JPLabsystems/JPL.mp3/README.md

# JPL.mp3
*The iPod endgame does not exist.*  
An iPod-esque mp3 player based on the ESP32 platform.

See YouTube video and Blog post for more details!
