JPLabsystems/JPL.mp3/production/README.md

## Note

It is highly recomended that you review all source files carefully before manufacturing this device. Source code particularly has many unresolved bugs which may impact user experience
