JPLabsystems/JPL.mp3/cad/NEWBackplate.3mf

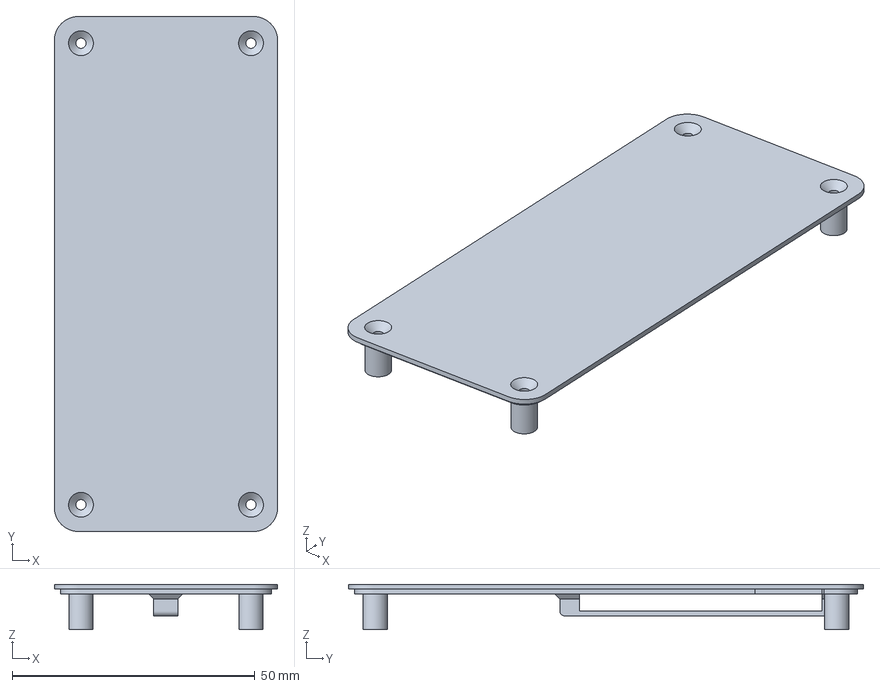
[picture p1: CAD file, 2025-09-06]
cad/NEWBackplate.3mf
46.0 x 106.0 x 9.35 mm
