JPLabsystems/JPL.mp3/production/3d_print/backplate.3mf

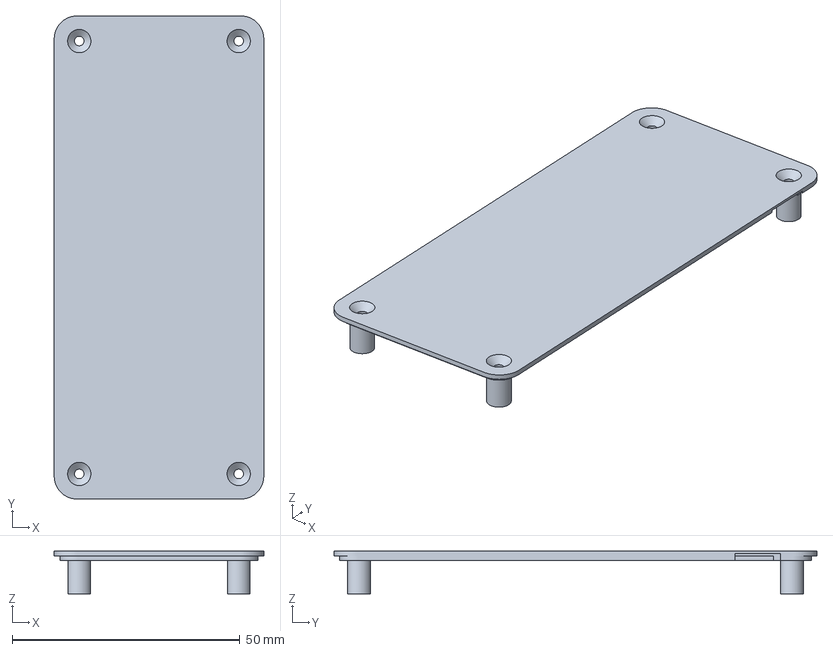
[picture p2: CAD file, 2025-08-03]
production/3d_print/backplate.3mf
46.0 x 106.0 x 9.35 mm
