JPLabsystems/JPL.mp3/cad/m1.44mmphilips.FCStd

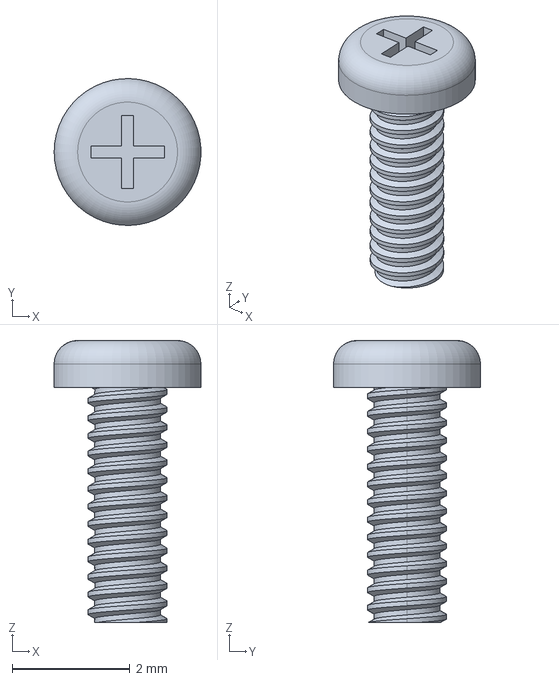
[picture p3: CAD file, 2025-07-11]
cad/m1.44mmphilips.FCStd
2.50 x 2.50 x 4.80 mm
