JPLabsystems/JPL.mp3/production/3d_print/slider.3mf

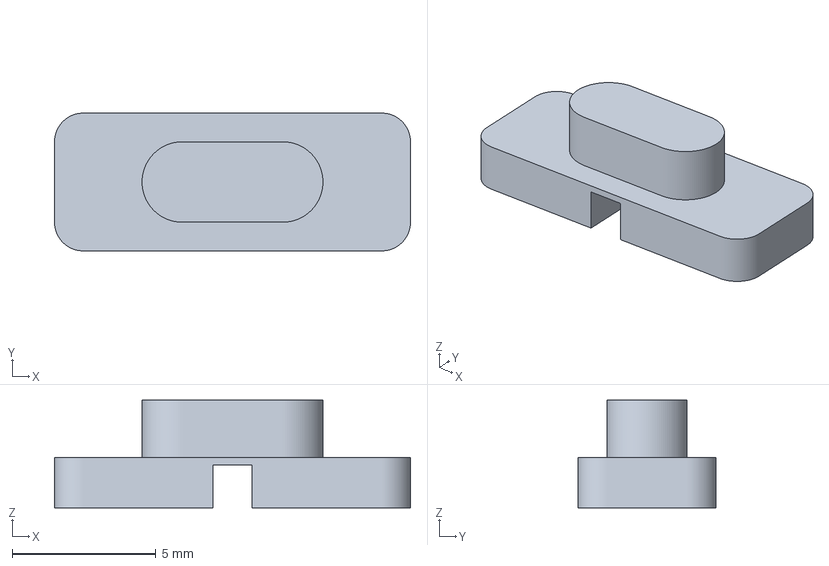
[picture p4: CAD file, 2025-08-03]
production/3d_print/slider.3mf
12.4 x 4.80 x 3.75 mm
