JPLabsystems/JPL.mp3/cad/m214mmcstorx.FCStd

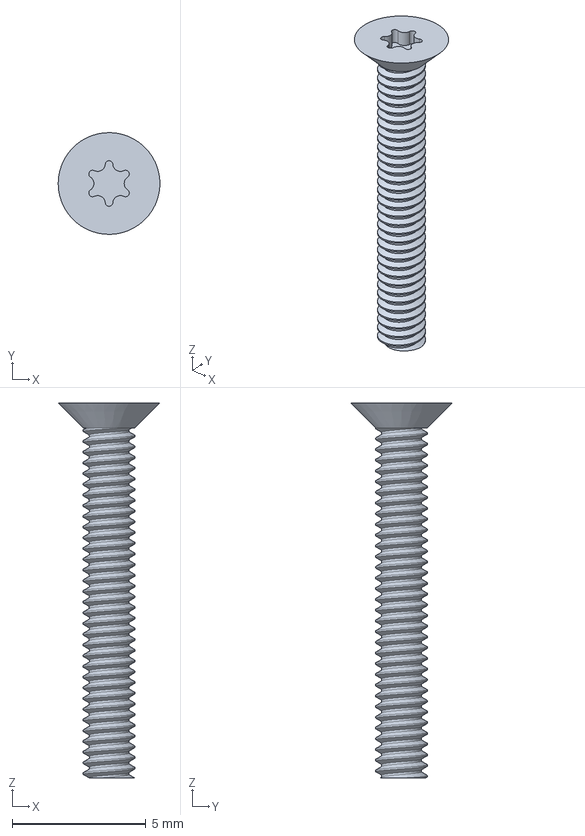
[picture p5: CAD file, 2025-07-11]
cad/m214mmcstorx.FCStd
3.80 x 3.80 x 14.0 mm
