JPLabsystems/JPL.mp3/production/3d_print/housing.3mf

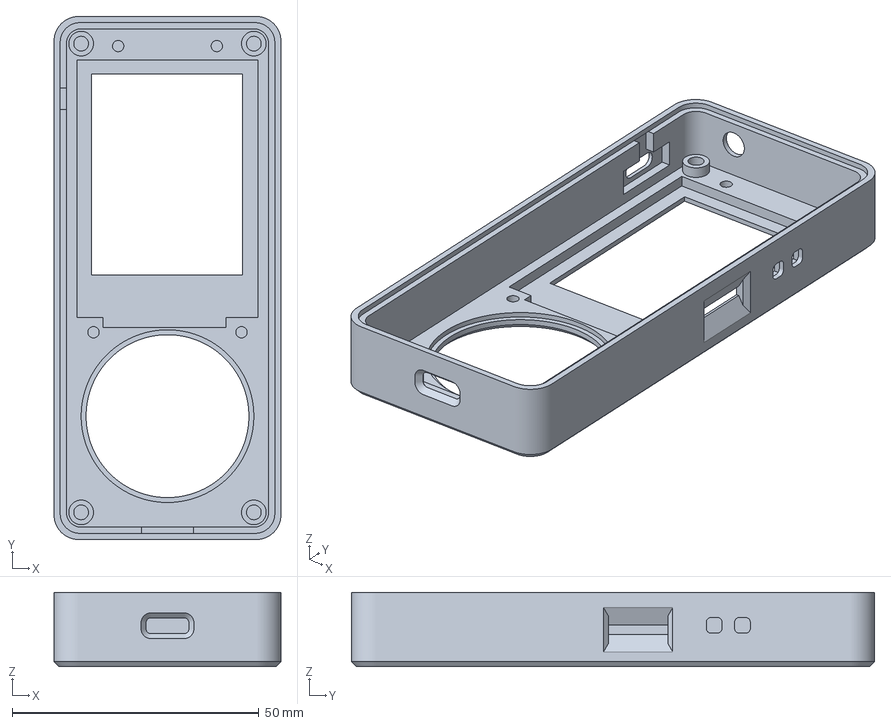
[picture p6: CAD file, 2025-08-03]
production/3d_print/housing.3mf
46.0 x 106.0 x 15.0 mm
