JPLabsystems/JPL.mp3/cad/PCB.FCStd

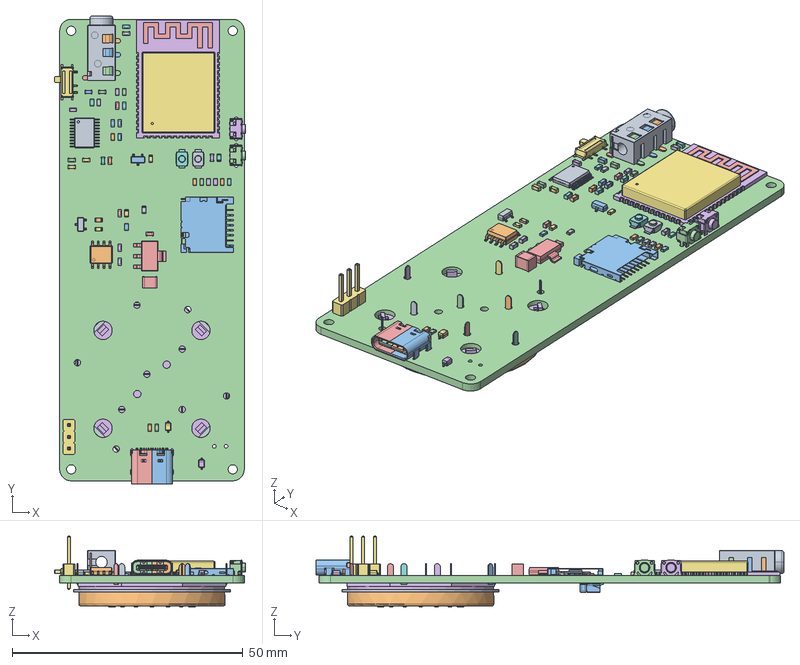
[picture p7: CAD file, 2025-07-11]
cad/PCB.FCStd
41.5 x 101.4 x 15.3 mm
PJ320D
PJ320D001
PJ320D002
PJ320D003
PJ320D004
R_0603_1608Metric
R_0603_1608Metric002
R_0603_1608Metric004
C_0603_1608Metric
C_0603_1608Metric002
SOT_23
R_0603_1608Metric006
ESP32-S3-WROOM-1
ESP32-S3-WROOM-002
ESP32-S3-WROOM-003
ESP32-S3-WROOM-004
ESP32-S3-WROOM-005
ESP32-S3-WROOM-006
ESP32-S3-WROOM-007
ESP32-S3-WROOM-008
ESP32-S3-WROOM-009
ESP32-S3-WROOM-010
ESP32-S3-WROOM-011
ESP32-S3-WROOM-012
ESP32-S3-WROOM-013
ESP32-S3-WROOM-014
ESP32-S3-WROOM-015
ESP32-S3-WROOM-016
ESP32-S3-WROOM-017
ESP32-S3-WROOM-018
ESP32-S3-WROOM-019
ESP32-S3-WROOM-020
ESP32-S3-WROOM-021
ESP32-S3-WROOM-022
ESP32-S3-WROOM-023
ESP32-S3-WROOM-024
ESP32-S3-WROOM-025
ESP32-S3-WROOM-026
ESP32-S3-WROOM-027
ESP32-S3-WROOM-028
ESP32-S3-WROOM-029
ESP32-S3-WROOM-030
ESP32-S3-WROOM-031
ESP32-S3-WROOM-032
ESP32-S3-WROOM-033
ESP32-S3-WROOM-034
ESP32-S3-WROOM-035
ESP32-S3-WROOM-036
ESP32-S3-WROOM-037
ESP32-S3-WROOM-038
ESP32-S3-WROOM-039
ESP32-S3-WROOM-040
ESP32-S3-WROOM-041
ESP32-S3-WROOM-042
ESP32-S3-WROOM-043
ESP32-S3-WROOM-044
ESP32-S3-WROOM-045
ESP32-S3-WROOM-046
ESP32-S3-WROOM-047
ESP32-S3-WROOM-048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
