JPLabsystems/JPL.mp3/production/3d_print/midplate.3mf

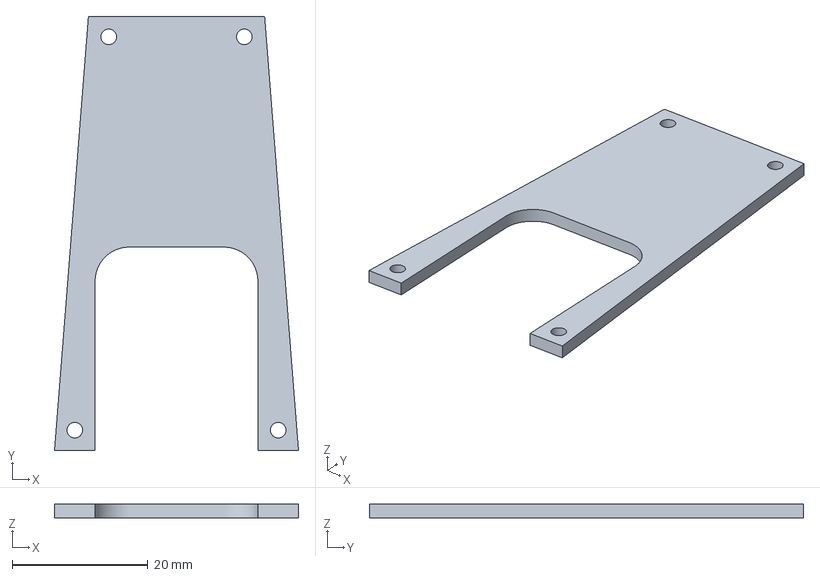
[picture p8: CAD file, 2025-08-03]
production/3d_print/midplate.3mf
36.0 x 64.0 x 2.00 mm
