JPLabsystems/JPL.mp3/cad/displayHS20HS072RX.FCStd

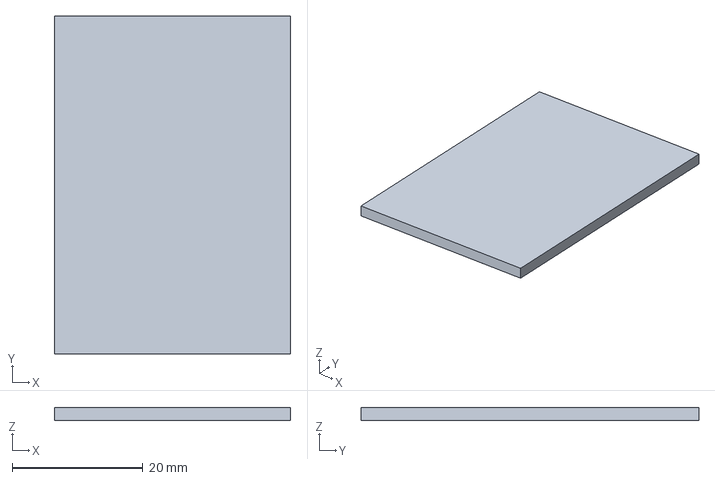
[picture p9: CAD file, 2025-07-11]
cad/displayHS20HS072RX.FCStd
36.2 x 51.8 x 2.05 mm
