JPLabsystems/JPL.mp3/production/3d_print/button.3mf

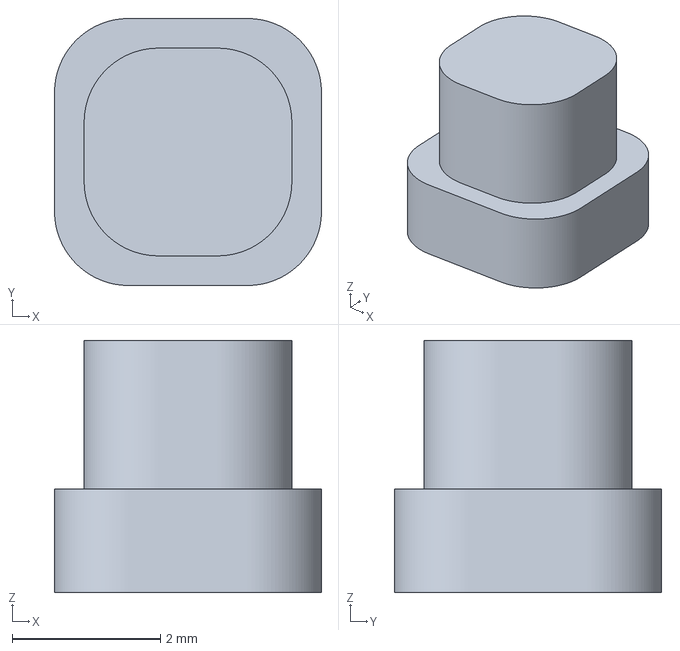
[picture p10: CAD file, 2025-08-03]
production/3d_print/button.3mf
3.60 x 3.60 x 3.40 mm
