JPLabsystems/JPL.mp3/cad/LiPo.FCStd

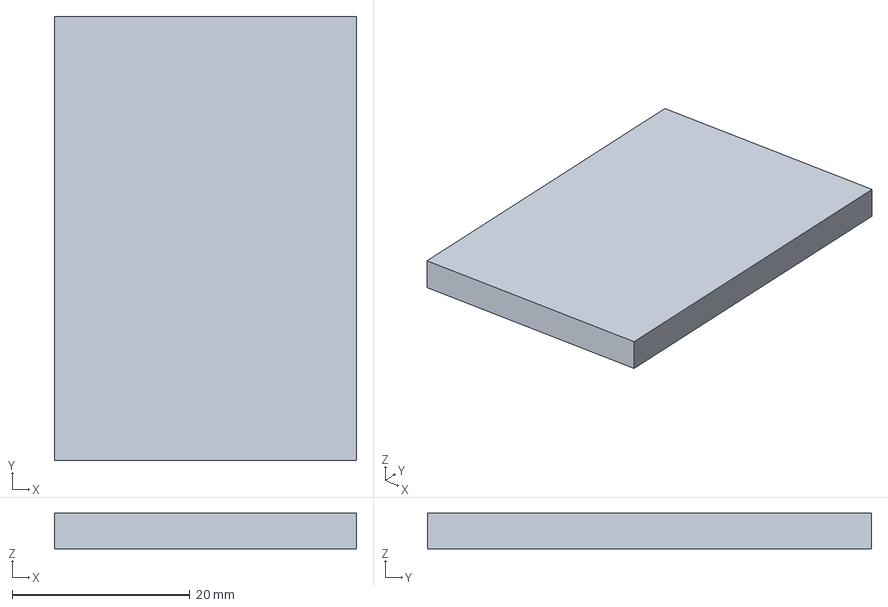
[picture p11: CAD file, 2025-07-11]
cad/LiPo.FCStd
34.0 x 50.0 x 4.00 mm
