JPLabsystems/JPL.mp3/(list of files, cad)

Other CAD files:
cad/Slider.FCStd
cad/Body.FCStd
cad/Button.FCStd
