JPLabsystems/JPL.mp3/eda/JPL.mp3.kicad_pcb

## KiCad design eda/JPL.mp3.kicad_pcb (2025-01-02)

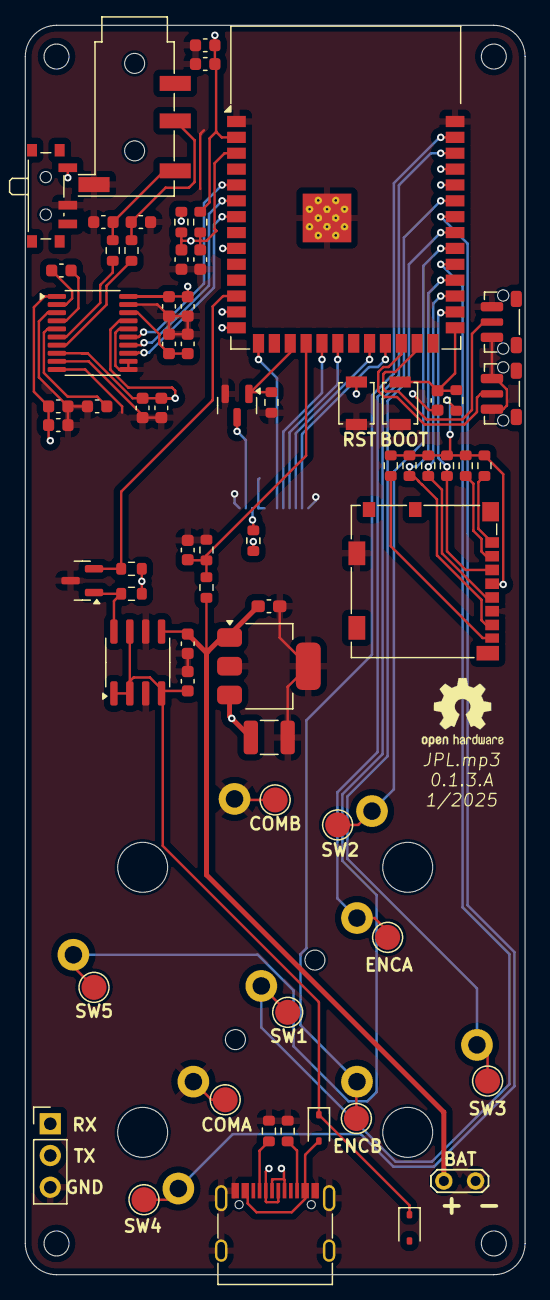
[picture p12: board JPL.mp3.kicad_pcb from above]

Board: 4 copper layers, 40.0 x 100.0 mm, 70 parts (1 on the bottom side), 51 nets.

Parts:
BAT: TestPoint_2Pads_Pitch2.54mm_Drill0.8mm
BOOT1: BOOT; SW_SPST_B3U-1000P
C1: .47uF; C_0603_1608Metric_Pad1.08x0.95mm_HandSolder
C2: 47uF; C_1210_3225Metric
C3, C4: 2.2nF; C_0603_1608Metric
C5, C9, C15, C19, C21: .1uF; C_0603_1608Metric
C6, C10, C16, C20, C23: 10uF; C_0603_1608Metric
C7: 2.2 uF; C_0603_1608Metric
C8: 10 nF; C_0603_1608Metric
C11, C13: 0.1uF; C_0603_1608Metric
C12: 1uF; C_0603_1608Metric
C14: 4.7 uF; C_0603_1608Metric
C17, C18: 2.2uF; C_0603_1608Metric
COMA: TestPoint_Pad_D2.0mm
COMB: TestPoint_Pad_D2.0mm
D1, D2: 1N5819WS; D_SOD-323
ENCA: TestPoint_Pad_D2.0mm
ENCB: TestPoint_Pad_D2.0mm
Enc1: ANO Rotary Encoder
J1: Micro_SD_Card; microSD_HC_Molex_104031-0811
J2: USB_C; USB_C_Receptacle_G-Switch_GT-USB-7010ASV
J4: Conn_01x12; TE_1-1734839-2_1x12-1MP_P0.5mm_Horizontal
J5: AudioJack3; Jack_3.5mm_KoreanHropartsElec_PJ-320D-4A_Horizontal
J6: Conn_01x03_Pin; PinHeader_1x03_P2.54mm_Vertical
Q1, Q2: BSS138; SOT-23
R1, R2: 5.1K; R_0603_1608Metric
R3, R8, R9, R10, R11, R13, R14, R15, R16, R17, R18, R19: 10K; R_0603_1608Metric
R4, R5: 470; R_0603_1608Metric
R6, R7: 100K; R_0603_1608Metric
R12: 10; R_0603_1608Metric
RST1: SW_SPST; SW_SPST_B3U-1000P
SL2: HOLD; SW_SPDT_PCM12
SW1, SW2#2, SW3, SW4, SW5: TestPoint_Pad_D2.0mm
SW1#2, SW2: SW_Push; SW_Push_1P1T-MP_NO_Horizontal_Alps_SKRTLAE010
U1: ESP32-S3-WROOM-1
U2: MAX1811; SOIC-8_3.9x4.9mm_P1.27mm
U4: PCM5102A; TSSOP-20_4.4x6.5mm_P0.65mm
U5: LT1963AxST-3.3; SOT-223-3_TabPin2

Connections:
+3.3V: C2.1, C6.1, C9.1, C10.1, C15.1, C19.2, C20.1, C21.2, C23.1, J1.4 (VDD), J4.8, J4.9, R3.1, R8.2, R9.1, R10.2, R12.1, R13.2, R14.1, R15.2, R16.2, R17.1, R18.1, R19.1, U1.2 (3V3), U4.1 (CPVDD), U4.8 (AVDD), U4.17 (XSMT), U4.20 (DVDD), U5.3 (OUT)
+5V: C14.1, D1.1 (K), D2.1 (K), U2.1 (SELV), U2.2 (SELI), U2.4 (IN), U2.7 (EN)
AUDIO_LEFT: C3.1, J5.T, R4.2
AUDIO_RIGHT: C4.1, J5.R1, R5.2
BACKLIGHT: Q2.1 (G), R11.1, U1.17 (GPIO9/TOUCH9/ADC1_CH8/FSPIHD/SUBSPIHD)
BAT_SENSE: C8.2, R6.2, R7.1, U1.18 (GPIO10/TOUCH10/ADC1_CH9/FSPICS0/FSPIIO4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)
CHG: Q1.2 (S), R10.1, U1.12 (GPIO8/TOUCH8/ADC1_CH7/SUBSPICS1)
ENCA: Enc1.A, U1.38 (GPIO2/TOUCH2/ADC1_CH1)
ENCB: Enc1.B, U1.39 (GPIO1/TOUCH1/ADC1_CH0)
GND: BAT.2, BOOT1.2 (B), C1.2, C2.2, C3.2, C4.2, C5.1, C6.2, C7.2, C8.1, C9.2, C10.2, C11.2, C12.2, C13.2, C14.2, C15.2, C16.1, C18.2, C19.1, C20.2, C21.1, C23.2, Enc1.COM_A, Enc1.COM_B, J1.6 (VSS), J1.11, J2.A1 (GND), J2.A12 (GND), J2.B1 (GND), J2.B12 (GND), J2.S1 (SHIELD), J4.1, J4.12, J5.S, J6.3, Q1.3 (D), Q2.2 (S), R1.2, R2.2, R7.2, R11.2, RST1.1 (A), SL2.2 (B), SW1#2.1, SW2.1, U1.1 (GND), U1.40 (GND), U1.41 (GND), U2.3 (GND), U2.6 (GND), U4.3 (CPGND), U4.9 (AGND), U4.10 (DEMP), U4.11 (FLT), U4.12 (SCK), U4.16 (FMT), U4.19 (DGND), U5.2 (GND)
HOLD: SL2.1 (A), U1.9 (GPIO16/U0CTS/ADC2_CH5/XTAL_32K_N)
I2S_LRCLK: U1.5 (GPIO5/TOUCH5/ADC1_CH4), U4.15 (LRCK)
I2S_SCLK: U1.7 (GPIO7/TOUCH7/ADC1_CH6), U4.13 (BCK)
I2S_SD: U1.6 (GPIO6/TOUCH6/ADC1_CH5), U4.14 (DIN)
unnamed: BOOT1.1 (A), C11.1, R17.2, U1.27 (GPIO0/BOOT)
unnamed: C1.1, C7.1, R6.1, U2.5 (BATT), U5.1 (IN)
unnamed: D1.2 (A), J2.A4 (VBUS), J2.A9 (VBUS), J2.B4 (VBUS), J2.B9 (VBUS)
unnamed: J1.8 (DAT1), R8.1
unnamed: J1.1 (DAT2), R9.2
unnamed: J1.2 (DAT3/CD), R3.2
unnamed: J2.A5 (CC1), R1.1
unnamed: J2.B5 (CC2), R2.1
unnamed: J4.10, R12.2
unnamed: J4.11, Q2.3 (D)
unnamed: Q1.1 (G), R13.1, U2.8 (~CHG)
unnamed: C12.1, C13.1, R18.2, R19.2, RST1.2 (B), U1.3 (EN)
unnamed: C17.2, U4.4 (CAPM)
unnamed: C17.1, U4.2 (CAPP)
unnamed: C5.2, C16.2, U4.18 (LDOO)
unnamed: R4.1, U4.6 (OUTL)
unnamed: R5.1, U4.7 (OUTR)
unnamed: C18.1, U4.5 (VNEG)
SD_CLK: J1.5 (CLK), R16.1, U1.29 (SPIIO7/GPIO36/FSPICLK/SUBSPICLK)
SD_CMD: J1.3 (CMD), R14.2, U1.28 (SPIIO6/GPIO35/FSPID/SUBSPID)
SD_D0: J1.7 (DAT0), R15.1, U1.30 (SPIDQS/GPIO37/FSPIQ/SUBSPIQ)
SW1: Enc1.S1, U1.31 (GPIO38/FSPIWP/SUBSPIWP)
SW2: Enc1.S2, U1.32 (MTCK/GPIO39/CLK_OUT3/SUBSPICS1)
SW3: Enc1.S3, U1.33 (MTDO/GPIO40/CLK_OUT2)
SW4: Enc1.S4, U1.34 (MTDI/GPIO41/CLK_OUT1)
SW5: Enc1.S5, U1.35 (MTMS/GPIO42)
TFT_CS: J4.2, U1.23 (GPIO21)
TFT_DC: J4.3, U1.22 (GPIO14/TOUCH14/ADC2_CH3/FSPIWP/FSPIDQS/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)
TFT_RST: J4.6, U1.15 (GPIO3/TOUCH3/ADC1_CH2)
TFT_SCLK: J4.4, U1.20 (GPIO12/TOUCH12/ADC2_CH1/FSPICLK/FSPIIO6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)
TFT_SDA: J4.5, U1.19 (GPIO11/TOUCH11/ADC2_CH0/FSPID/FSPIIO5/S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)
UART_RX: J6.1, U1.36 (U0RXD/GPIO44/CLK_OUT2)
UART_TX: J6.2, U1.37 (U0TXD/GPIO43/CLK_OUT1)
USB_D+: J2.A6 (D+), J2.B6 (D+), U1.14 (GPIO20/U1CTS/ADC2_CH9/CLK_OUT1/USB_D+)
USB_D-: J2.A7 (D-), J2.B7 (D-), U1.13 (GPIO19/U1RTS/ADC2_CH8/CLK_OUT2/USB_D-)
VOL_DOWN: SW2.2, U1.24 (GPIO47/SPICLK_P/SUBSPICLK_P_DIFF)
VOL_UP: SW1#2.2, U1.25 (GPIO48/SPICLK_N/SUBSPICLK_N_DIFF)
