JPLabsystems/JPL.mp3/src/src/config.h

#ifndef config_h
#define config_h

/////////PIN DEFINITIONS/////////

#define batSensePin 10
#define chargeSensePin 8

#define TFT_CS 21
#define TFT_RST 3
#define TFT_DC 14

// encoder pins
#define encA 1
#define encB 2

const int left = 40;
#define up 39
#define down 41
#define right 42
#define center 38
#define vUp 47
#define vDown 48
const int hold = 16;

// #define I2S_MCLK 3
#define I2S_DOUT 6
#define I2S_BCLK 7
#define I2S_LRC 5

#endif
