JPLabsystems/JPL.mp3/src/src/List.cpp

/*#include "List.h"

const char *queries[]{
    "SELECT piecename FROM library ORDER BY composer",
    "SELECT DISTINCT composer FROM library",
    "SELECT DISTINCT era FROM library",
    "SELECT piecename FROM library WHERE composer = ?",
    "SELECT piecename FROM library WHERE era = ?",
    "SELECT filepath FROM library WHERE piecename = ?",
    "SELECT * FROM library WHERE piecname = ?",

    "SELECT filepath, piecename, composer, performer, instrumentation FROM library WHERE filepath = ?",
    "SELECT piecename FROM library WHERE filepath = ?",

    "SELECT * FROM library ORDER BY RANDOM() LIMIT 1"};

List::List(int condition)
{
    switch(condition)
    {
        case 1:
            //
            break;
        case 2:
            //
            break;
    }
}
*/
