JPLabsystems/JPL.mp3/src/src/List.h

/*#ifndef List_h
#define List_h

#include <vector>

class List
{
    public:
        List(int condition);

        

    private:
        std::vector<String> ti\\\\\\\\\\\\\\\\\\\\\tleList;
}

#endif
*/
