JPLabsystems/JPL.mp3/(commit log)

2025-07-11 more cad
    [PCB.FCStd, displayHS20HS072RX.FCStd, m1.44mmphilips.FCStd, m214mmcstorx.FCStd]
2025-08-03 production files
    [backplate.3mf, button.3mf, housing.3mf, midplate.3mf, slider.3mf]
2025-08-03 Fixed bom
2025-09-06 Add files via upload
    Modified Backplate
    [NEWBackplate.3mf]
